Orion-North/S.O.L.A.R./docs/assets/README.md

# Media Assets

This folder contains non-image media referenced by the README.

Current media:

- `hero-walking-control-panel.mp4`
