Orion-North/S.O.L.A.R./PARTS_LIST.md

# Master Parts List: S.O.L.A.R. Quadruped
### Microcontrollers & Processing
* [ESP32-CAM (Edge Controller)](https://www.amazon.ca/ESP32-CAM-Development-Aideepen-ESP32-CAM/dp/B0FNMNSWQQ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)
* [PCA9685 16-Channel I2C PWM Controller](https://www.amazon.ca/dp/B0CRV3MK14?ref=ppx_yo2ov_dt_b_fed_asin_title)
* [Host PC with RTX 5080 (for off-board RL)](https://www.bestbuy.ca/en-ca/product/hp-omen-16-max-16-gaming-laptop-shadow-black-intel-core-ultra-9-275hx-64gb-ram-2tb-ssd-geforce-rtx-5080/19195148)

### Actuators & Motion
* [12x MG90S Metal Gear Micro Servos](https://www.amazon.ca/dp/B0CP98TZJ2?ref=ppx_yo2ov_dt_b_fed_asin_title&th=1)

### Power & Energy Management
* [2x 5V 1W Monocrystalline Solar Panels](https://www.amazon.ca/dp/B09V264DS6?ref=ppx_yo2ov_dt_b_fed_asin_title)
* Solar LiPo Charger Module - Some random one from Aliexpress
* [5V 5A BEC (Step-Down Regulator)](https://www.amazon.ca/Voltage-Regulator-Synchronous-Rectification-Helicopter/dp/B0DP1P15BY/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)
* 7.4V 2S High-Discharge LiPo Battery

### Structural & Custom Parts
* [PLA-CF filament (for 3D printed frame components)](https://ca.store.bambulab.com/products/pla-cf?variant=541209453249892354)
* [TPU 95A HF filament (for 3D printed feet)](https://ca.store.bambulab.com/products/tpu-95a-hf?variant=541209416100941825)
* [Assorted M3 hardware (screws, washers, nuts)](amazon.ca/dp/B0DJ8DTHB9?ref=ppx_yo2ov_dt_b_fed_asin_title)
