Orion-North/S.O.L.A.R./simulation/assets/solar/solar_proxy.obj

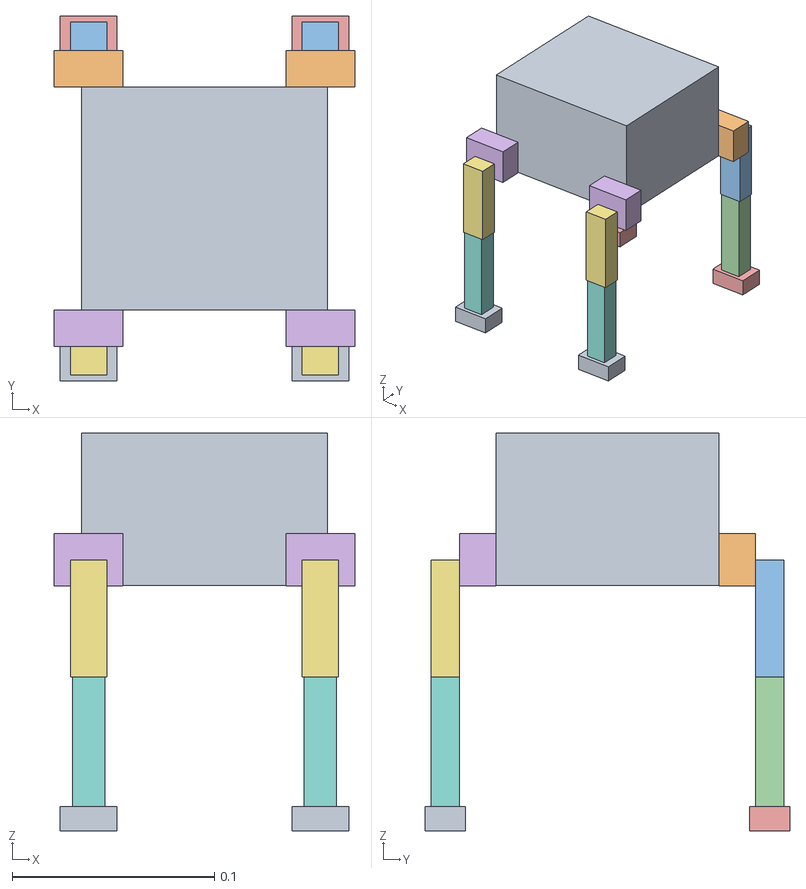
[picture p1: CAD file, 2026-06-06]
simulation/assets/solar/solar_proxy.obj
0.149 x 0.18 x 0.197
base_link
FL_hip_link
FL_thigh_link
FL_calf_link
FL_foot
FR_hip_link
FR_thigh_link
FR_calf_link
FR_foot
RL_hip_link
RL_thigh_link
RL_calf_link
RL_foot
RR_hip_link
RR_thigh_link
RR_calf_link
RR_foot
