Orion-North/S.O.L.A.R./(commit log)

2026-05-11 Refine status LED handling and RL starter docs
2026-06-02 Update battery charging objective status in README
2026-06-06 Add beta deliverable and solar RL integration
    [solar.urdf, solar_proxy.obj]
2026-10-09 feat(firmware): fix camera feed and add play bow and curious emotes
    [solar_main.ino]
2026-10-10 Improve SOLAR firmware reliability and control panel safety
    Preserve authenticated web OTA, separate camera transfers, fix exact servo resets, and bound synchronized debug logging. Include IMU calibration, safer panel controls, regression tests, documentation, and gait source snapshots. Exclude local credentials and compiled firmware images.
    [bounded_text_log.h, camera_transfer.h, debug_log.h, imu_bus.h, imu_calibration.h, test_debug_log.py]
